Serra-Rocketry/thrust-stand/docs/README.md

# 📚 Documentação Técnica - Sistema de Teste Estático

Esta documentação reúne o necessário para montagem, calibração, operação e troubleshooting do sistema baseado em ESP32.

## 🗂️ Estrutura da Documentação

### 1. Guia de Instalação

- Requisitos de hardware e software
- Configuração do ambiente
- Primeira execução

### 2. [Hardware](./HARDWARE.md)

- Lista de componentes (BOM)
- Mapeamento de pinos e conexões
- Função dos botões e do LED

### 3. [Firmware](./FIRMWARE.md)

- Arquitetura e fluxo de aquisição
- Calibração da célula de carga
- Sistema de arquivos e armazenamento

### 4. [API e Protocolos](./API.md)

- Comandos seriais
- Controles físicos
- Exemplos de interação

### 5. [Troubleshooting](./TROUBLESHOOTING.md)

- Problemas comuns e diagnóstico rápido
- Procedimentos de correção

### 6. [Evolução da Caixa](./EVOLUÇÃO_CAIXA.md)

- Histórico das 3 versões da estrutura física
- Comparativo de materiais e design

### 7. [V3 Detalhes](./V3_DETALHES.md)

- Especificações da bancada v3
- Célula de carga, guia linear, resolução

## 📊 Diagramas Técnicos

Arquitetura do sistema:

```
[Sensores] -> [ESP32] -> [Armazenamento] -> [Comunicação]
    |            |             |               |
 Célula/ADS1256 Process.     microSD        Serial/BT
 Pressão       Dados         Arquivo CSV    Monitoramento
```

Fluxo de dados:

```mermaid
graph TD;
    A[Sensores] --> B[Aquisição];
    B --> C[Processamento];
    C --> D[Armazenamento SD];
    C --> E[Transmissão];
    D --> F[Arquivo CSV];
    E --> G[Serial];
    E --> H[Bluetooth];
```

## 🛠️ Recursos Técnicos

### Especificações do Sistema

- Microcontrolador: ESP32
- Sensores: célula de carga e sensor de pressão analógico, ambos lidos pelo ADC ADS1256 (24 bits), e termopar tipo K (MAX31855)
- Amostragem: 500 Hz (empuxo e pressão), 8 Hz (temperatura)
- Armazenamento: cartão SD (SPI), com fallback para LittleFS
- Comunicação: Serial USB e Bluetooth
- Controles físicos:
  - Botão `GPIO33`: TARE
  - LED `GPIO19`: aceso durante gravação no SD
  - Buzzer `GPIO32`: sinalização

### Formatos de Dados

- Logs: CSV (`Tempo,Empuxo,Pressao`)
- Configuração: `Preferences` (fator de calibração)
- Comunicação: comandos por texto

## 🤝 Contribuindo para a Documentação

1. Reporte inconsistências encontradas
2. Proponha melhorias de texto e organização
3. Abra PR com correções objetivas
