Serra-Rocketry/thrust-stand/hardware/teste_estatico/kicad/projeto kicad/_restore_backup_2026-05-29T19-16-41-364/teste_estatico.kicad_pcb

## KiCad design hardware/teste_estatico/kicad/projeto kicad/_restore_backup_2026-05-29T19-16-41-364/teste_estatico.kicad_pcb (2026-09-26)

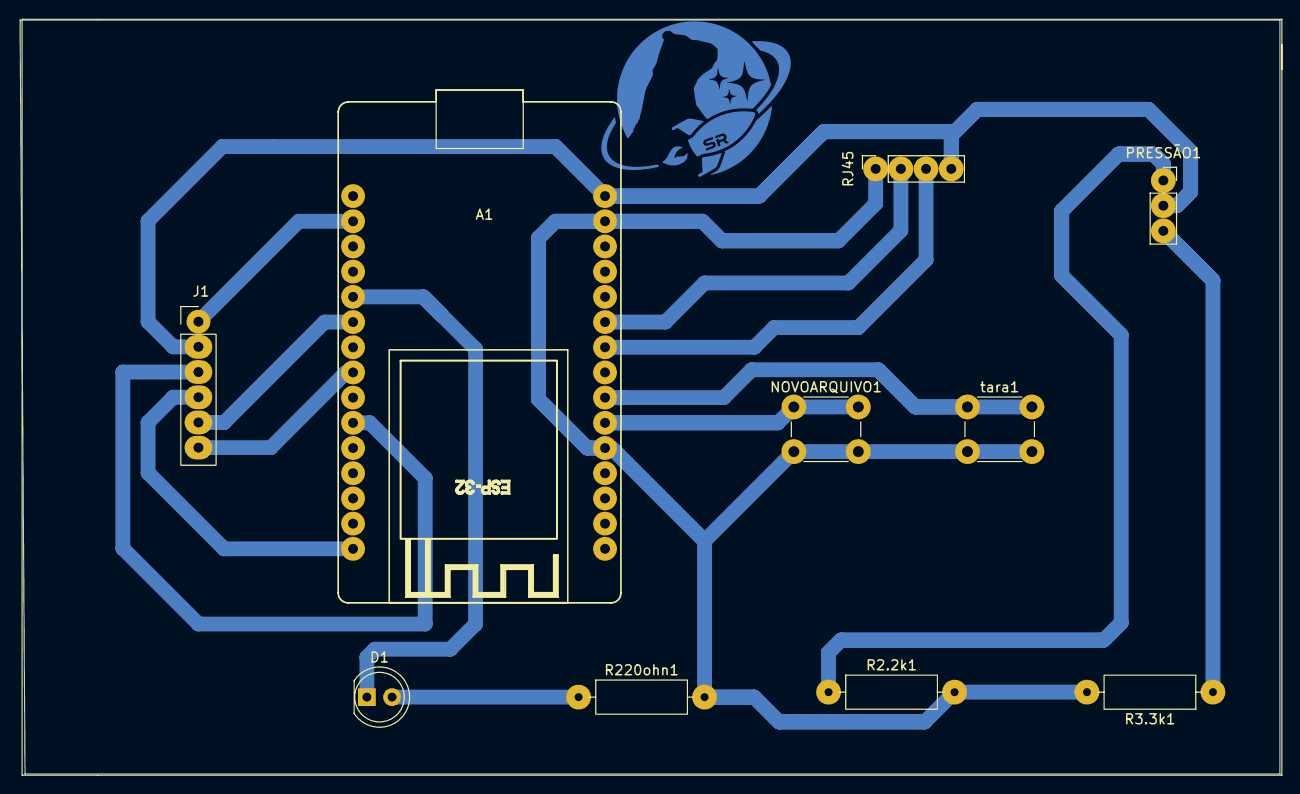
[picture p1: board hardware/teste_estatico/kicad/projeto kicad/_restore_backup_2026-05-2… from above]

Board: 2 copper layers, 127.0 x 76.0 mm, 10 parts (0 on the bottom side), 14 nets.

Parts:
A1: ESP32_DevKit_V1_DOIT_30GPIOs; DOIT_ESP32_DEVKIT_30Pins
D1: LED; LED_D5.0mm_FlatTop
J1: PINHD_1x6_Female; PinSocket_1x06_P2.54mm_Vertical
NOVOARQUIVO1: Push_Button; SW_PUSH_6mm
PRESSÃO1: Sensor de pressão; PinSocket_1x03_P2.54mm_Vertical
R2.2k1, R3.3k1, R220ohn1: R; R_Axial_DIN0309_L9.0mm_D3.2mm_P12.70mm_Horizontal
RJ45: conexão do rj45; PinSocket_1x04_P2.54mm_Vertical
tara1: Push_Button; SW_PUSH_6mm

Connections:
unnamed: A1.21 (ADC1_CH4/D32), NOVOARQUIVO1.1
unnamed: A1.22 (ADC1_CH4/D32), tara1.1
unnamed: A1.20 (ADC1_CH7/D35), A1.29 (GND), NOVOARQUIVO1.2, R2.2k1.2, R3.3k1.2, R220ohn1.2, RJ45.1, tara1.2
unnamed: A1.25 (ADC2_CH7/D27), RJ45.2
unnamed: A1.5 (D4/ADC2_CH0), D1.1 (K)
unnamed: A1.8 (D5), J1.6
unnamed: A1.10 (D19), J1.3
unnamed: A1.15 (D23), J1.4
unnamed: A1.24 (DAC2/ADC2_CH9/D26), RJ45.3
unnamed: A1.2 (GND), J1.1
unnamed: A1.6 (RX2/GPIO16), J1.5
unnamed: A1.30 (VIN), J1.2, PRESSÃO1.2, RJ45.4
unnamed: D1.2 (A), R220ohn1.1
unnamed: PRESSÃO1.1, R2.2k1.1
