Serra-Rocketry/thrust-stand/hardware/teste_estatico/kicad/projeto kicad/teste_estatico.kicad_pcb

## KiCad design hardware/teste_estatico/kicad/projeto kicad/teste_estatico.kicad_pcb (2026-09-26)

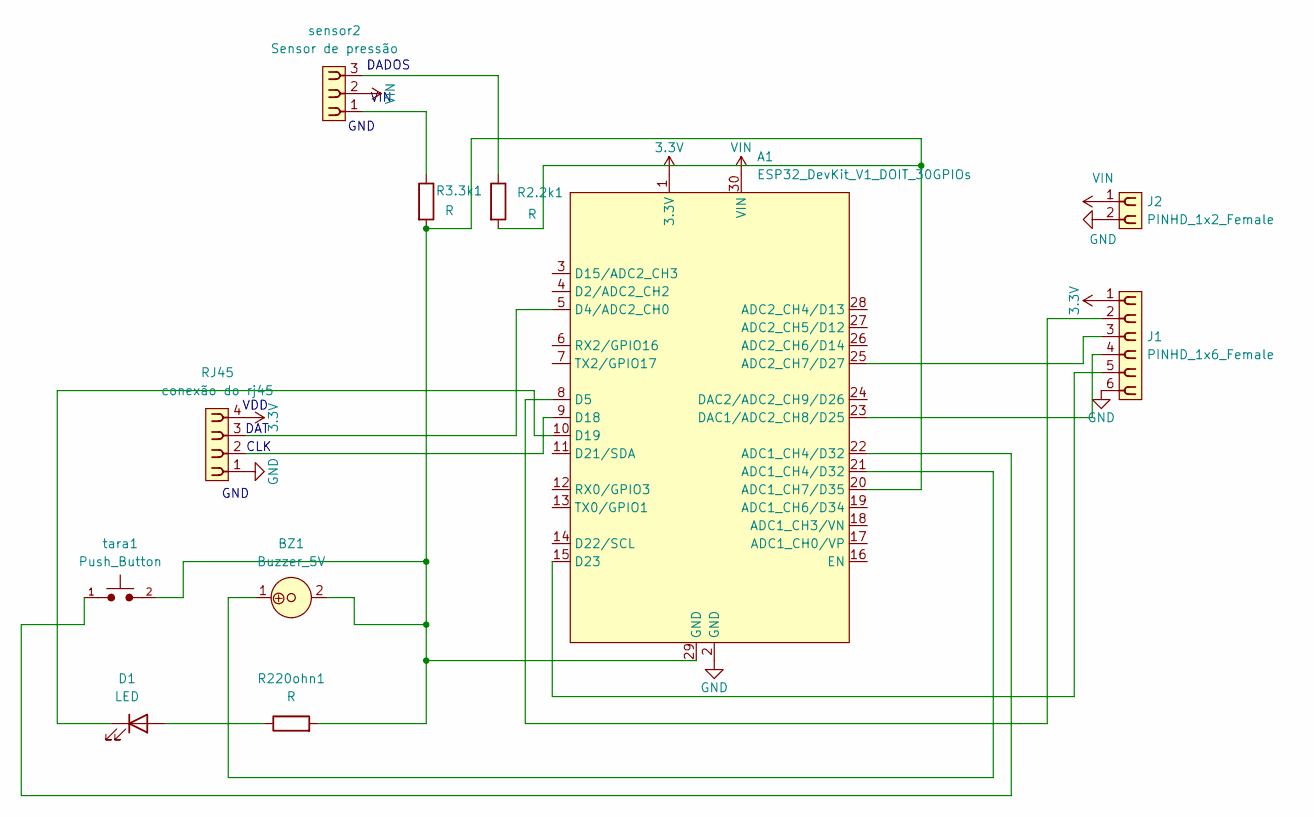
[picture p2: schematic teste_estatico.kicad_sch]

Parts:
A1: ESP32_DevKit_V1_DOIT_30GPIOs; DOIT_ESP32_DEVKIT_30Pins
BZ1: Buzzer_5V; MagneticBuzzer_ProSignal_ABT-410-RC
D1: LED; LED_D5.0mm_FlatTop
J1: PINHD_1x6_Female; PinSocket_1x06_P2.54mm_Vertical
J2: PINHD_1x2_Female; PinSocket_1x02_P2.54mm_Vertical
R2.2k1, R3.3k1, R220ohn1: R; R_Axial_DIN0309_L9.0mm_D3.2mm_P12.70mm_Horizontal
RJ45: conexão do rj45; PinSocket_1x04_P2.54mm_Vertical
sensor2: Sensor de pressão; PinSocket_1x03_P2.54mm_Vertical
tara1: Push_Button; SW_PUSH_6mm

Connections:
3.3V: A1.1 (3.3V), J1.1, RJ45.4
GND: A1.2 (GND), J1.6, J2.2, RJ45.1
unnamed: A1.21 (ADC1_CH4/D32), BZ1.1
unnamed: A1.22 (ADC1_CH4/D32), tara1.1
unnamed: A1.20 (ADC1_CH7/D35), A1.29 (GND), BZ1.2, R2.2k1.2, R3.3k1.2, R220ohn1.2, tara1.2
unnamed: A1.25 (ADC2_CH7/D27), J1.3
unnamed: A1.5 (D4/ADC2_CH0), RJ45.3
unnamed: A1.8 (D5), J1.2
unnamed: A1.9 (D18), RJ45.2
unnamed: A1.10 (D19), D1.1 (K)
unnamed: A1.15 (D23), J1.5
unnamed: A1.23 (DAC1/ADC2_CH8/D25), J1.4
unnamed: D1.2 (A), R220ohn1.1
unnamed: R2.2k1.1, sensor2.3
unnamed: R3.3k1.1, sensor2.1
VIN: A1.30 (VIN), J2.1, sensor2.2

Notes on the sheet:
DADOS
DAT
GND
CLK
VIN
VDD

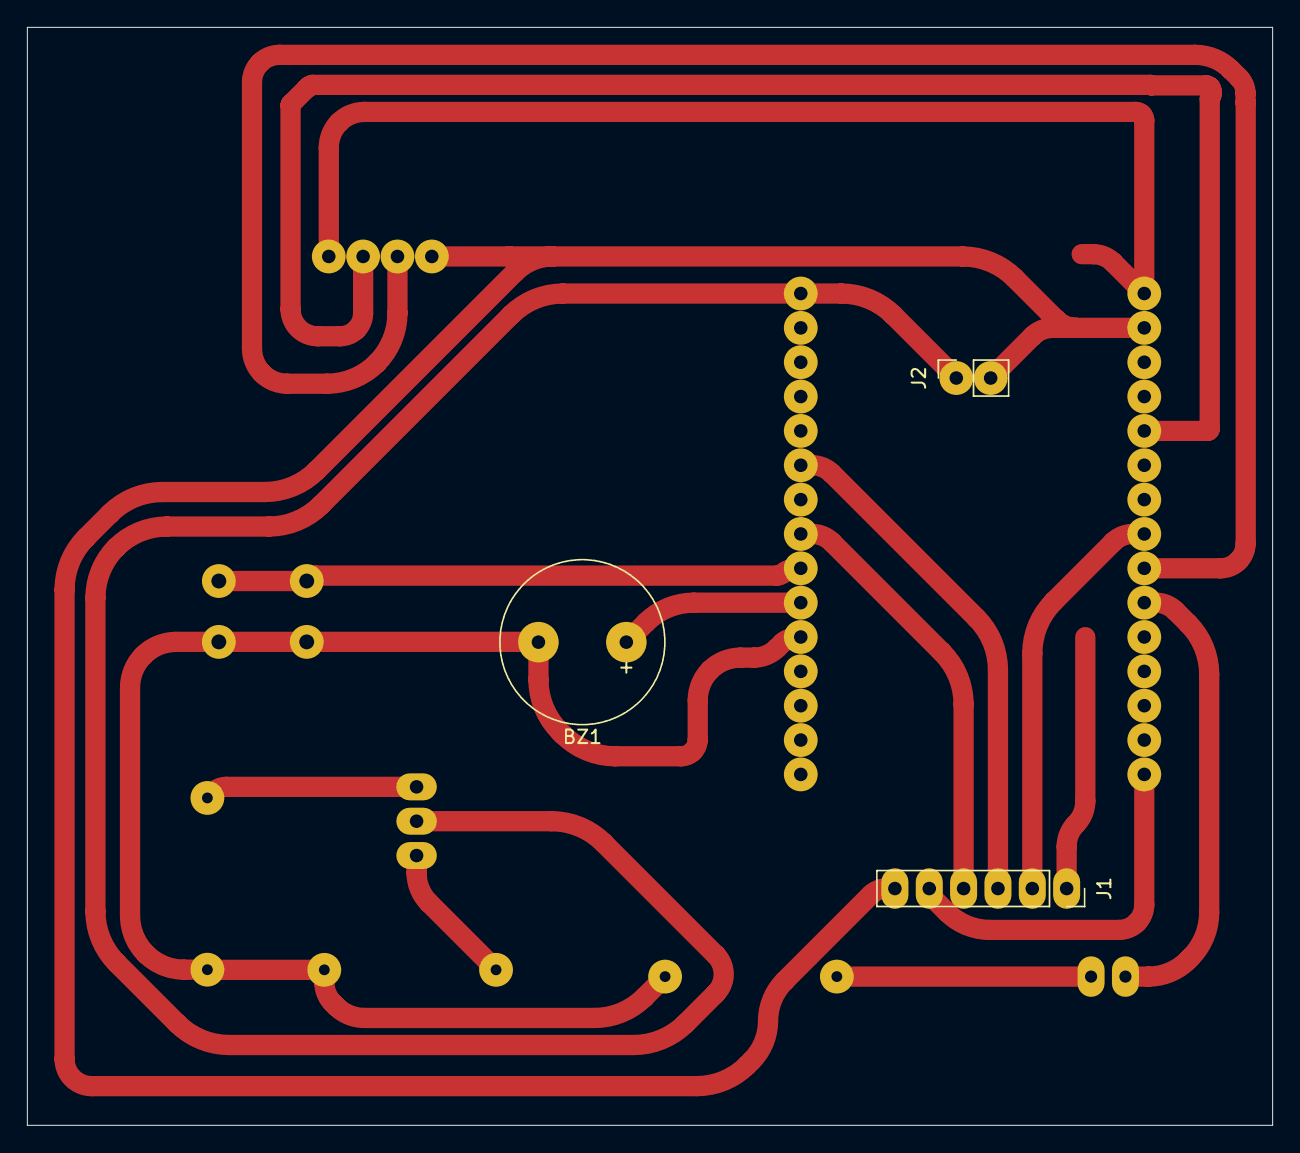
[picture p3: board hardware/teste_estatico/kicad/projeto kicad/teste_estatico.kicad_pcb from above]

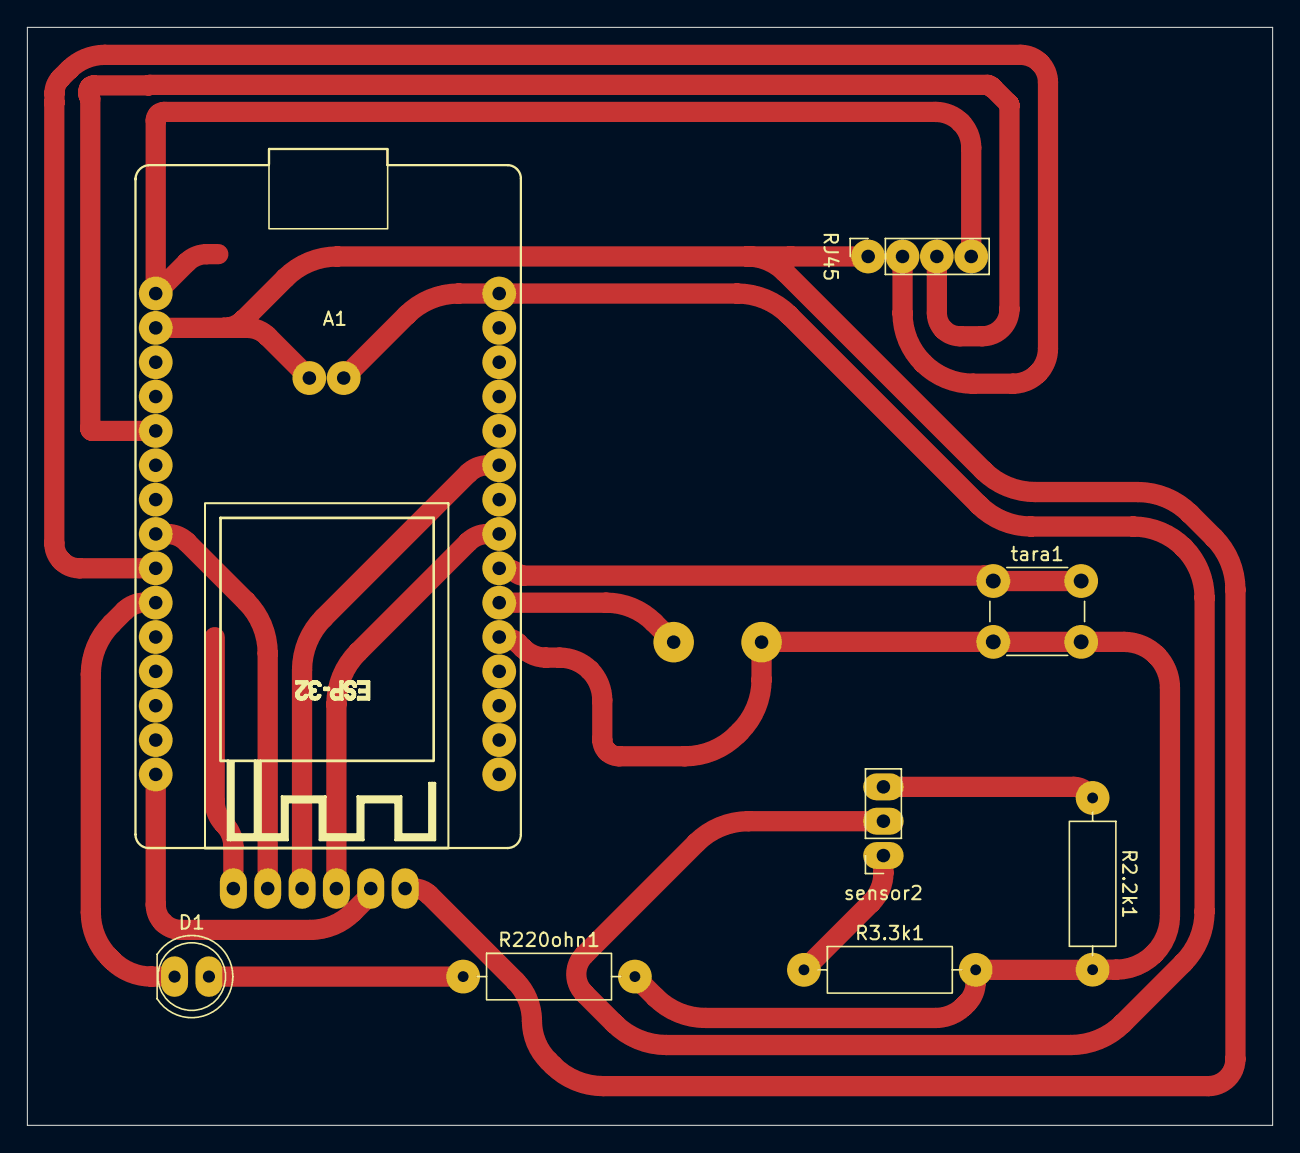
[picture p4: board hardware/teste_estatico/kicad/projeto kicad/teste_estatico.kicad_pcb from below]

Board: 2 copper layers, 92.1 x 81.2 mm, 11 parts (8 on the bottom side), 16 nets.
