Serra-Rocketry/thrust-stand/software/config-load-cell/fator_de_calibracao/fator_de_calibracao_cli.py

import sys
import time
import string
import serial
import serial.tools.list_ports
# from datetime import datetime


def try_parse_int(line: str) -> int | None:
    """Best-effort parsing for the ESP32 calibration stream.

    During calibration the firmware should stream raw integers, but it can also
    print status lines. This helper ignores non-integer lines.
    """
    if line is None:
        return None
    s = line.strip()
    if not s:
        return None
    try:
        return int(float(s))
    except ValueError:
        return None

class Receiver():
    def __init__(
            self,
            port: str,
            baudrate: int = 115200,
            timeout: float = 0.1,
        ):

        self.port = port
        self.baudrate = baudrate
        self.timeout = timeout

        try:
            self.serial:serial.Serial = serial.Serial(
                port=port,
                baudrate=baudrate,
                timeout=timeout,
                xonxoff=False,
                rtscts=False,
                write_timeout=timeout,
                dsrdtr=False,
                inter_byte_timeout=None
            )
        except serial.SerialException as e:
            print(f'WARNING: Serial Exception')
            print(e)
            # self.serial = None
            raise

    def read_response(self):
        # errors='replace': bytes corrompidos no boot do ESP não derrubam a leitura
        return self.serial.readline().decode('utf-8', errors='replace').strip()

    def check_connection(self):
        return self.serial.is_open

    def send_command(self, command):
        self.serial.write(command)

    def close(self):
        self.serial.close()

def enter_config_mode(com: Receiver, attempts: int = 5, timeout_s: float = 3.0) -> bool:
    """Manda INIT CONFIG e espera o ESP confirmar o modo de calibração.

    O INIT CONFIG faz a tara da célula, então ela precisa estar SEM peso.
    Antes da confirmação o ESP ainda pode estar transmitindo as linhas de
    dados, por isso a resposta é procurada por até timeout_s segundos.
    """
    for attempt in range(attempts):
        com.serial.reset_input_buffer()
        com.send_command(b'INIT CONFIG\n')

        deadline = time.monotonic() + timeout_s
        while time.monotonic() < deadline:
            line = com.read_response()
            if 'Modo calibracao ativo' in line or 'Aguardando' in line:
                print(f"[handshake] configMode confirmado na tentativa {attempt + 1}")
                return True
            if 'nao respondeu' in line:
                print(f"[handshake] {line}")
                break

    return False

def get_samples(com: Receiver, n_samples: int = 200) -> list[int]:
    """Lê n_samples valores brutos do modo de calibração.

    O próprio ESP controla o ritmo (uma leitura a cada 200 ms), então não
    há espera aqui: esperar fazia ler valores antigos acumulados no buffer.
    """
    com.serial.reset_input_buffer()

    samples = []
    while com.check_connection() and len(samples) < n_samples:
        value = try_parse_int(com.read_response())
        if value is None:
            continue
        samples.append(value)
        print(f"Sample {len(samples)}: {value}")

    return samples

def get_calibration_factor(samples: list[int], expected_weight: float):

    samples_sum = sum(samples)
    samples_amnt = len(samples)
    samples_avg = samples_sum/samples_amnt

    calibration_factor = samples_avg / expected_weight

    return calibration_factor

def list_ports():
    if sys.platform.startswith('win'):  # For Windows
        return [port.device for port in serial.tools.list_ports.comports()]
    elif sys.platform.startswith(('linux', 'cygwin')):  # For Linux and Cygwin
        return [port.device for port in serial.tools.list_ports.comports() if port.device.startswith('/dev/ttyUSB') or port.device.startswith('/dev/ttyACM')]
    else:
        print("ERRO: Plataforma não identificada")
        raise

def print_ports() -> None:
    ports = list_ports()
    print("Portas COM disponiveis: ")
    for idx, port in enumerate(ports):
        print(f"({idx}) {port}")

def choose_port_by_index():

    print_ports()

    while True:

        try:
            ports = list_ports() 
            choice = int(input("Digite o número da porta desejada\n-> "))
            port = ports[choice]
            return port

        except ValueError:
            print("ERRO: Valor Inválido!")
            return 'ERROR!!!'

def main(argv: list[str]) -> int:

    # TODO: [x] instantiate comunication interface "com"
    # TODO: [x] make "print_ports()"
    # TODO: [x] make "list_ports()"
    # TODO: [x] make "choose_port_by_index()"

    port = choose_port_by_index()
    com = Receiver(port)

    n_samples = int(input("Digite nº de amostras para calibrar a pesagem (recomendado: 200):\n-> "))
    expected_weight = float(input("Digite o peso real em kg (ex.: 10.5):\n-> ").replace(',', '.'))

    # 1) Tara sem peso: o INIT CONFIG zera a célula
    input("\nRetire todo o peso da célula de carga e aperte Enter para fazer a tara...")
    if not enter_config_mode(com):
        print("ERRO: o ESP não entrou no modo de calibração. Verifique a conexão.")
        com.close()
        return 1

    # 2) Peso de referência
    input(f"Tara feita. Coloque o peso de {expected_weight} kg, espere estabilizar e aperte Enter...")
    print("Iniciando leitura das amostras...")

    samples = get_samples(com, n_samples=n_samples)
    if not samples:
        print("ERRO: nenhuma amostra recebida.")
        com.close()
        return 1

    calibration_factor = get_calibration_factor(samples, expected_weight)
    print(f"Fator de Calibração: {calibration_factor}")

    # 3) Salvar no ESP (sai do modo de calibração)
    if input("Enviar este fator para o ESP? [s/N] -> ").strip().lower() == 's':
        com.send_command(f'SET LOAD FACTOR {calibration_factor}\n'.encode('utf-8'))
        time.sleep(0.5)
        for _ in range(10):
            line = com.read_response()
            if line and try_parse_int(line) is None:
                print(line)

    com.close()
    return 0

if __name__ == "__main__":
    exit(main(sys.argv))
