Serra-Rocketry/thrust-stand/(commit log)

2026-11-13 chore(hardware): remover arquivos automáticos do KiCad do versionamento
    Remove do Git os backups automáticos (zips e _restore_backup), o cache
    de footprints, as preferências locais (.kicad_prl), o arquivo de trava
    (.lck) e os diretórios .history, que tinham entrado por engano como
    submódulos quebrados. Os arquivos continuam no disco; o .gitignore
    passa a ignorá-los.
    Refs #6
2026-11-13 chore: mover firmware antigo e scripts de calibração do HX711 para Legacy
    Move para Legacy/, mantendo o caminho original:
    - extras/old/ (firmware antigo, com RTC e relé, nos pinos 26/27)
    - Config.ino, Verify.ino, Calibrar.py e DadosSerial.py (fluxo antigo de
    calibração, já marcado como legado no README)
    - Dados.txt e Dados-Teste-Estatico/ (leituras brutas do HX711, que não
    valem para o ADS1256)
    Atualiza as referências no README da calibração e no AGENTS.md.
    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
2026-11-13 chore: mover cópia duplicada do sketch de calibração manual para Legacy
    software/Fator manual/calibracao/calibracao.ino era idêntico a
    software/fatordecalibracao/fatordecalibracao.ino (só mudava a quebra de
    linha no fim do arquivo). Fica a versão sem espaço no nome da pasta,
    que será portada para o ADS1256.
    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
2026-11-13 chore(hardware): mover PCB do Fusion, gerbers antigos e esquemático do Fritzing para Legacy
    - Fusion 360/testeserra1.*: PCB de 2026-05, substituída pelo projeto KiCad
    - kicad/gerber/: gerbers de 2026-05-21; os atuais (2026-07-09) estão em
    kicad/projeto kicad/
    - docs/Esquematico.png e Untitled Sketch 2.fzz: esquemático do Fritzing
    com a ligação antiga (HX711 em 26/27, dois botões, sem buzzer)
    No HARDWARE.md, a imagem antiga é trocada por um link para o
    esquemático do KiCad.
    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
2026-11-13 chore: remover arquivos vazios
    extras/receiver-esp-now/receiver-esp-now.ino e tests/lcd/lcd.ino
    estavam vazios (0 bytes) desde que foram criados.
    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
2026-11-13 docs: documentar pasta Legacy e atualizar estrutura do repositório
    - Legacy/README.md explica o que foi movido e por quê
    - README.md: troca tests/ (removida) por Legacy/ na árvore do projeto e
    descreve melhor extras/
    - AGENTS.md: deixa de dizer que tests/ existe vazia
    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
2026-11-13 feat(firmware): adicionar driver do ADC ADS1256
    Classe em header-only (mesmo padrão do Pressure.h) que conversa com o
    ADS1256 via SPI, seguindo o datasheet SBAS288:
    - begin(): reset, confere o ID do chip, configura taxa e buffer
    - calibrate(): autocalibração (offset/ganho) guardada por canal, já que
    célula de carga e pressão usam PGAs diferentes
    - read(): grava MUX/ADCON/calibração do canal, SYNC/WAKEUP, espera o
    DRDY (com timeout) e lê os 24 bits com extensão de sinal
    - toVolts(): converte a leitura bruta em volts conforme o PGA
    Ainda não é usado pelo firmware.
    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
2026-11-13 refactor(firmware): ler a célula de carga pelo ADS1256 no lugar do HX711
    - Barramento SPI próprio (HSPI) para o ADS1256, separado do SD:
    SCLK=18 e DOUT=4 (reaproveitam as trilhas do HX711), DIN=13, CS=26,
    DRDY=34
    - Célula de carga em AIN0(+)/AIN1(-) com PGA 64 e taxa de 2000 SPS
    - Tara e conversão para kg passam a ser feitas no firmware
    (tareOffset e rawToKg), já que o ADS1256 não tem essas funções
    - A tara usa a média de 50 leituras (antes eram 10)
    - TARE pelo botão e pelo comando agora usam a mesma função (handleTare)
    - O modo de calibração continua enviando a leitura bruta menos a tara,
    no mesmo formato que o app Python espera
    O fator salvo no NVS (-284.6) era do HX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
2026-11-13 feat(firmware): ler o sensor de pressão pelo ADS1256
    O sensor de pressão sai do ADC interno do ESP32 (GPIO35), que é ruidoso
    e não linear, e passa para a entrada AIN2 do ADS1256 (contra AINCOM),
    com PGA 1 e calibração própria. O divisor 2,2k/3,3k continua: limita a
    tensão a 2,7 V, dentro da faixa de 0 a 3 V com o buffer ligado.
    O PressureSensor deixa de ler o pino e passa só a converter tensão em
    pressão (toMPa/toBar/toPSI); readADC() e begin() saem por falta de uso.
    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
2026-11-13 docs: atualizar pinagem e documentação para o ADS1256
    - HARDWARE.md: BOM com o módulo ADS1256 e a célula SZ51X-500kg, nova
    tabela de pinos (SCLK=18, DOUT=4, DIN=13, CS=26, DRDY=34), ligações
    no módulo (AIN0/AIN1 célula, AIN2 pressão, AINCOM no GND, PDWN em
    3,3 V) e cuidados com GND comum e nível lógico de 3,3 V
    - FIRMWARE.md: novo ADS1256.h na estrutura, sem a biblioteca HX711
    - TROUBLESHOOTING.md, docs/README.md, README.md, AGENTS.md e README da
    calibração: troca as referências ao HX711 e ao GPIO35
    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
2026-11-13 fix(firmware): remover abs() da leitura de empuxo
    O abs() retificava o ruído em torno de zero (a linha de base sem carga
    ficava sempre positiva) e escondia montagens com o sinal invertido.
    O sentido correto passa a vir do sinal do fator de calibração.
    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
2026-11-13 feat(firmware): fator de calibração teórico e nova chave no NVS para o ADS1256
    O fator salvo em "loadFactor" (padrão -284.6) era do HX711 e daria
    leituras sem sentido com o ADS1256. O fator passa a ser salvo na chave
    "fatorADS1256"; enquanto a célula não é calibrada, vale o fator teórico
    calculado pelo certificado da SZ51X-500kg (2 mV/V, 5 V, 500 kg) e pelo
    fundo de escala do ADS1256 no PGA 64: ~2147,5 contagens/kg.
    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
2026-11-13 fix(calibracao): fazer a tara sem peso antes de coletar as amostras na GUI
    O INIT CONFIG faz a tara da célula, mas a GUI o enviava com o peso de
    referência já em cima: a leitura ficava perto de zero e o fator saía
    errado. O fluxo agora é:
    1. a GUI pede para retirar o peso e envia INIT CONFIG (tara)
    2. depois da confirmação, pede para colocar o peso
    3. só então coleta as 200 amostras
    O handshake sai da SamplerThread para uma ConfigModeThread e para a
    função enter_config_mode() do módulo CLI, que procura a confirmação
    por até 3 s (com o ADS1256, o ESP envia muitas linhas de dados antes
    de entrar no modo de calibração). read_response() passa a tolerar
    bytes inválidos. O READM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
2026-11-13 fix(calibracao): fazer o CLI de calibração funcionar sozinho
    - Envia INIT CONFIG (com a célula sem peso) antes de coletar; antes
    ele lia as linhas CSV normais e descartava tudo
    - Peso real lido como float em kg (antes era int, perdia decimais)
    - get_samples() não espera mais 1 s entre amostras: o ESP já envia uma
    a cada 200 ms e a espera fazia ler valores antigos do buffer
    - Ao final, oferece enviar o fator com SET LOAD FACTOR
    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
2026-11-13 feat(calibracao): portar o sketch de calibração manual para o ADS1256
    - Lê a célula pelo ADS1256 com a mesma pinagem do firmware principal
    (antes usava HX711 em 26/27, que conflitava com o MOSI do SD na placa)
    - Leitura em kg (antes dizia "g"), média de 10 leituras por valor
    - Começa com o fator salvo no ESP ou com o fator teórico (~2147,5)
    - Nova tecla [S]: salva o fator na mesma chave de NVS ("fatorADS1256")
    que o firmware principal carrega no boot
    - ADS1256.h é copiado para a pasta do sketch, porque a Arduino IDE só
    compila arquivos que estão dentro dela
    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
2026-11-13 feat(firmware): amostrar a uma taxa fixa de 500 Hz
    O loop lia o mais rápido possível (INTERVALO de 1 ms, limitado de fato
    pelo ADC e pela gravação), com intervalos irregulares. Agora as amostras
    saem numa cadência fixa definida por TAXA_AMOSTRAGEM_HZ (500 por
    segundo, com base em micros()).
    500 Hz dá ~10 pontos numa subida de empuxo de 20 ms na ignição; 1000 Hz
    dobraria os dados e o ruído sem ganho real. Se o loop atrasar mais de
    um período, a cadência é retomada sem rajada de leituras.
    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
2026-11-13 feat(firmware): limitar a transmissão Serial/BT a 50 linhas por segundo
    A 500 Hz, cada linha (~30 bytes) somaria ~15 KB/s, mais que a Serial a
    115200 baud aguenta (~11,5 KB/s), e o envio travaria a aquisição. Agora
    só 1 a cada DECIMACAO amostras (TRANSMISSAO_HZ = 50) é transmitida.
    O arquivo no SD continua recebendo todas as amostras.
    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
2026-11-13 perf(firmware): gravar no SD por uma tarefa no núcleo 0, com fila
    Antes, cada amostra abria o arquivo, escrevia e fechava, no mesmo loop
    que lê os sensores: qualquer demora do cartão atrasava a aquisição.
    Agora:
    - loop() (núcleo 1) só lê os sensores e coloca a amostra numa fila
    (FreeRTOS, 1024 amostras, ~2 s a 500 Hz), sem nunca esperar
    - recordingTask (núcleo 0) tira da fila, grava no arquivo, atualiza os
    picos e transmite 1 a cada DECIMACAO por Serial/BT
    - o arquivo fica aberto o teste inteiro, com flush a cada 1 s (perde no
    máximo 1 s de dados se a energia cair)
    - se a fila encher, as perdas são contadas e avisadas por Serial/BT
    appendFile() sai, substituída pela taref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
2026-11-13 feat(firmware): comandos BT OFF e BT ON para pausar a transmissão por Bluetooth
    Com BT OFF, as linhas de dados deixam de ir pelo Bluetooth e o ESP
    manda só um resumo por segundo (tempo, empuxo atual, pico e pressão),
    para ficar focado em adquirir e gravar. O BT continua recebendo
    comandos (inclusive BT ON) e as respostas a eles; a Serial USB e a
    gravação no SD não mudam. No boot a transmissão começa ligada.
    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
2026-11-13 fix(firmware): criar o arquivo de dados só depois de o ADS1256 responder
    O arquivo era criado antes de testar o sensor. Quando o sensor falhava,
    o ESP reiniciava e criava outro Dados_NNN.txt vazio a cada boot, enchendo
    o cartão de arquivos só com o cabeçalho.
    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
2026-11-13 feat(firmware): adicionar driver do termopar MAX31855
    Classe header-only (mesmo padrão do ADS1256.h), sem dependência externa:
    - readCelsius(): lê os 32 bits via SPI (modo 0, 4 MHz) e converte a
    temperatura do termopar (14 bits, 0,25 °C), já com a compensação de
    junta fria feita pelo próprio chip
    - detecta termopar aberto, curto com GND/VCC e ausência do chip
    (lastFault())
    - internalCelsius(): temperatura da junta fria da última leitura
    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
2026-11-13 feat(firmware): gravar a temperatura do termopar tipo K (MAX31855)
    - MAX31855 no mesmo barramento SPI do ADS1256 (SCLK=18, SO=4), com
    CS próprio no GPIO21
    - Lido a cada 125 ms (o chip leva até 100 ms por conversão e ler mais
    rápido interromperia a conversão); entre leituras, cada amostra
    repete o último valor
    - Nova coluna no arquivo: Tempo,Empuxo,Pressao,Temperatura (em °C)
    - Opcional: se o termopar estiver ausente ou com falha, o boot avisa
    e a coluna é gravada como "nan", sem interromper o teste
    - O resumo do BT OFF também mostra a temperatura
    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
2026-11-13 fix(firmware): não travar a aquisição esperando o fim de um comando
    readStringUntil('\n') espera até o timeout da Stream (1 s por padrão)
    quando chega um comando sem quebra de linha, e nesse tempo nenhuma
    amostra era lida. O timeout da Serial e do BT passa a ser de 50 ms.
    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
2026-11-13 docs: documentar aquisição a 500 Hz, termopar, BT OFF/ON e nova calibração
    - FIRMWARE.md: chave NVS fatorADS1256 e fator teórico, nova ordem do
    setup, diagrama dos dois núcleos (aquisição -> fila -> gravação),
    tabela de taxas e por que 500 Hz, formato do CSV com Temperatura,
    comandos BT OFF/ON e compilação pelo arduino-cli
    - API.md: INIT CONFIG faz a tara (célula sem peso), BT OFF/ON, formato
    das linhas de dados e exemplo de calibração com o ADS1256
    - HARDWARE.md: MAX31855 e termopar na BOM, pino CS=21 e ligações
    - TROUBLESHOOTING.md: códigos de falha do termopar e amostras perdidas
    - README.md, docs/README.md e AGENTS.md: funcionalidades e armadilhas
    novas (cópi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
2026-11-13 docs(readme): corrigir link de clone e completar quick start e documentação
    - Link de clone apontava para ViniciusCMB/thrust-stand; agora é
    Serra-Rocketry/thrust-stand
    - "Sobre" inclui a temperatura
    - Quick start com instalação da Pushbutton, calibração e TARE/BT OFF
    - Pré-requisitos citam o Python do app de calibração
    - Lista de documentação inclui calibração, evolução da caixa, V3 e Legacy
    - Link de contribuidores deixa de estar vazio
    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
